efreyes2026-gif/STAB-KIT-PRO-SelfBalancingRobot/Otros/Fotos_Imagenes/PROT_1.jpeg

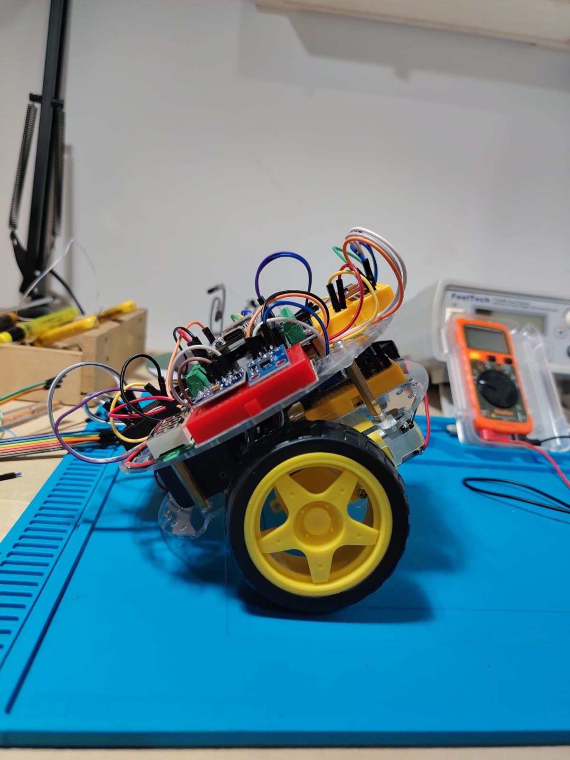
Otros/Fotos_Imagenes/PROT_1.jpeg
