efreyes2026-gif/STAB-KIT-PRO-SelfBalancingRobot/Otros/Fotos_Imagenes/Proteus_WokWI.png

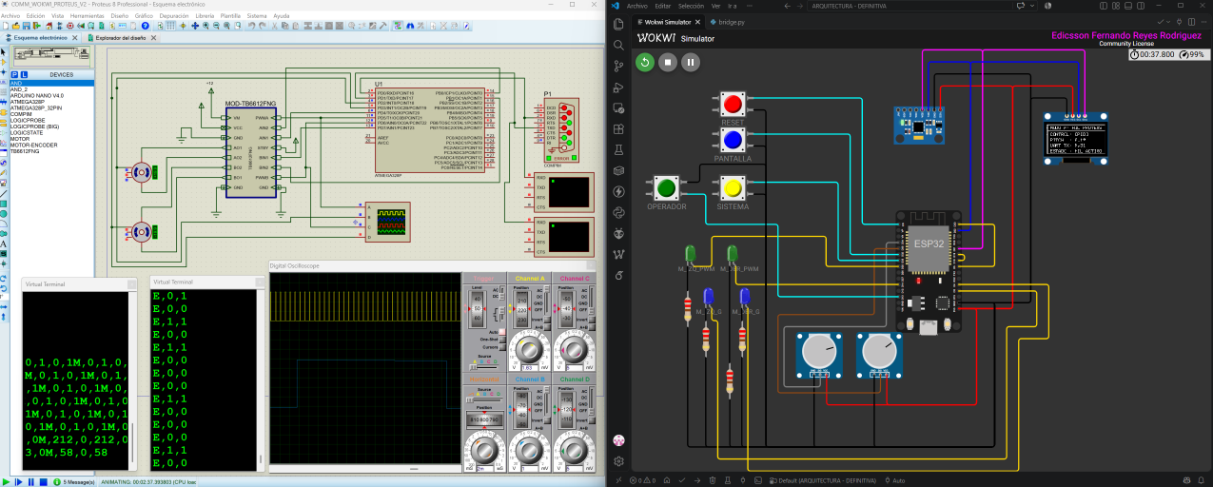
Otros/Fotos_Imagenes/Proteus_WokWI.png
