efreyes2026-gif/STAB-KIT-PRO-SelfBalancingRobot/Mod_3D_Autodesk_Inventor/Robot_Autoequilibrado/Robot_Autoequilibrado_Proyectado.png

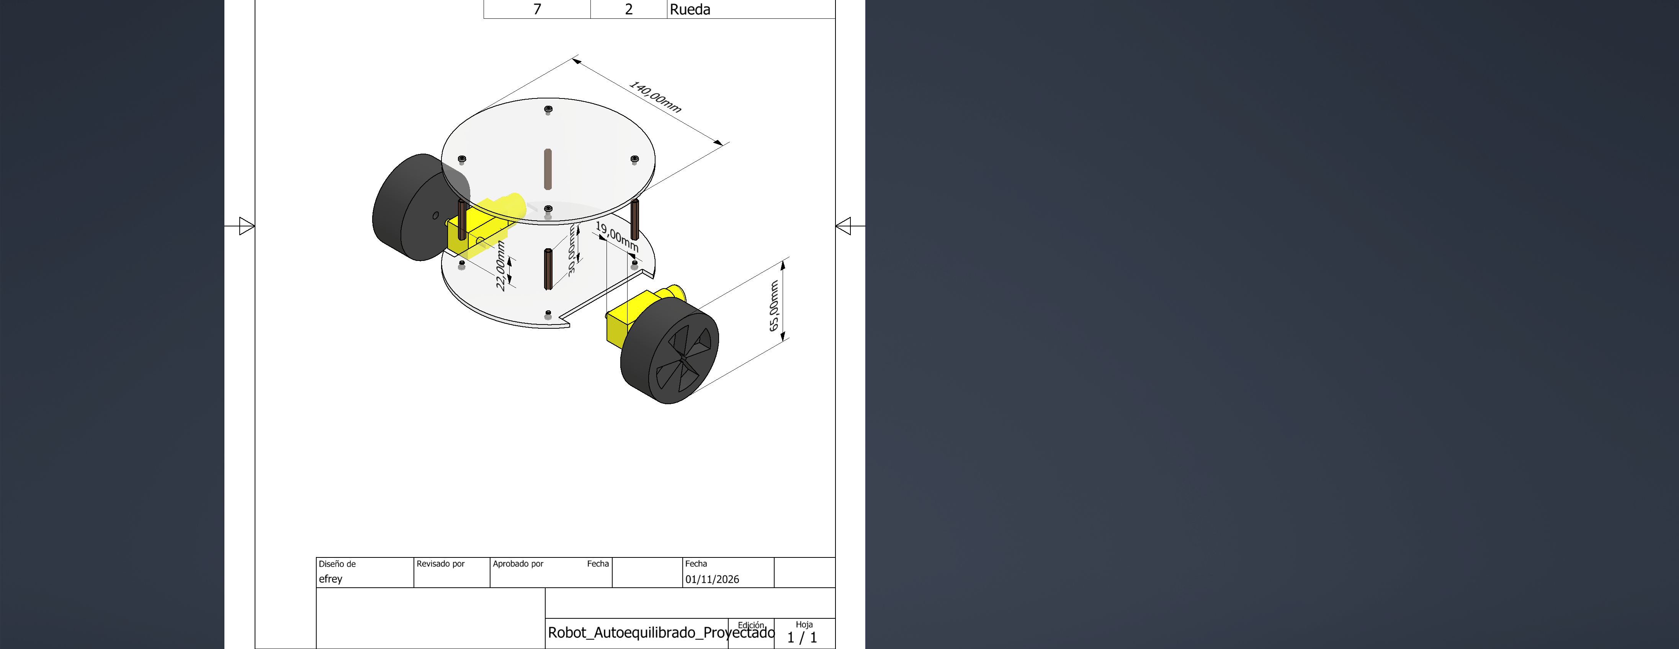
Mod_3D_Autodesk_Inventor/Robot_Autoequilibrado/Robot_Autoequilibrado_Proyectado.png
