efreyes2026-gif/STAB-KIT-PRO-SelfBalancingRobot/Otros/Diag_Flujo_Modelo_Matematico.png

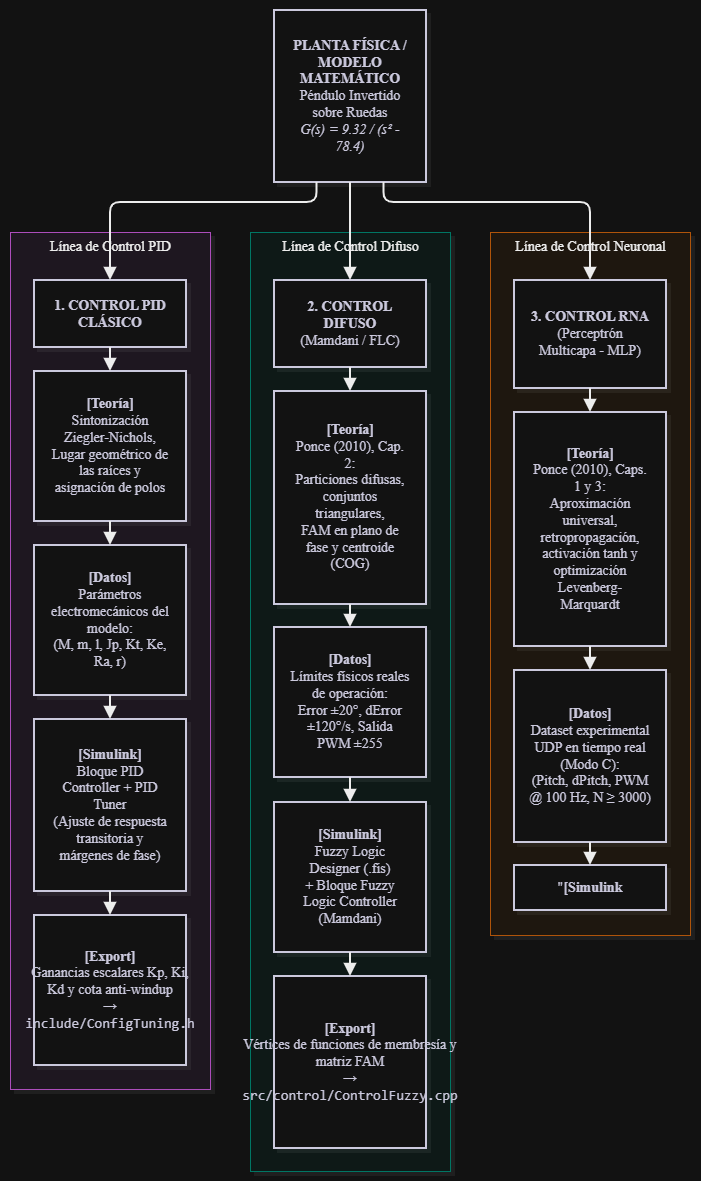
Otros/Diag_Flujo_Modelo_Matematico.png
