efreyes2026-gif/STAB-KIT-PRO-SelfBalancingRobot/Otros/Diagrama_Flujo_firmware.drawio.png

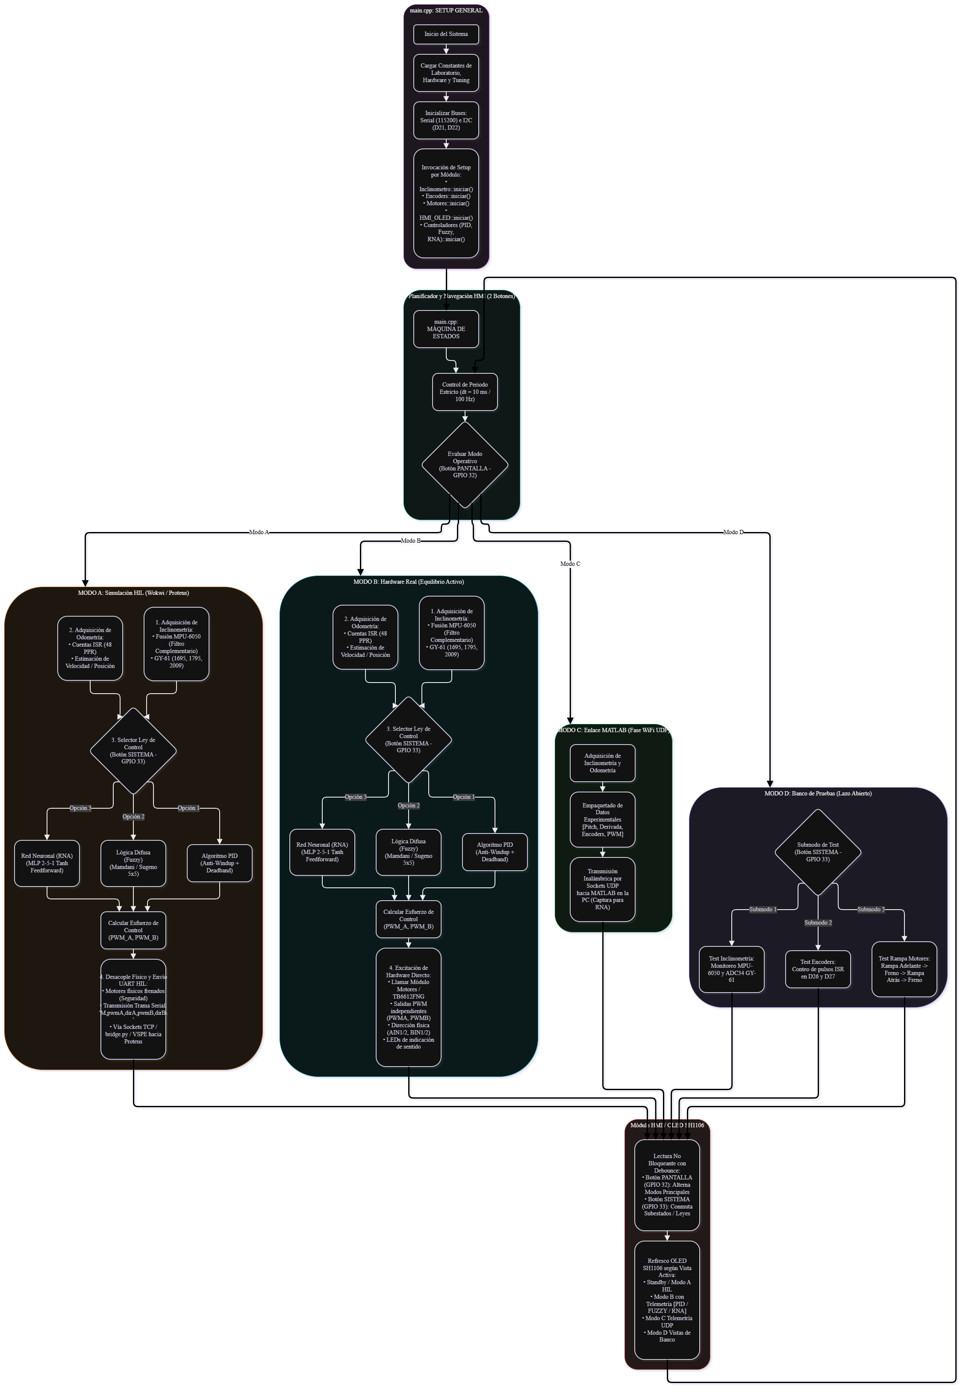
Otros/Diagrama_Flujo_firmware.drawio.png
