efreyes2026-gif/STAB-KIT-PRO-SelfBalancingRobot/Otros/Fotos_Imagenes/CONSOLA_KIT.png

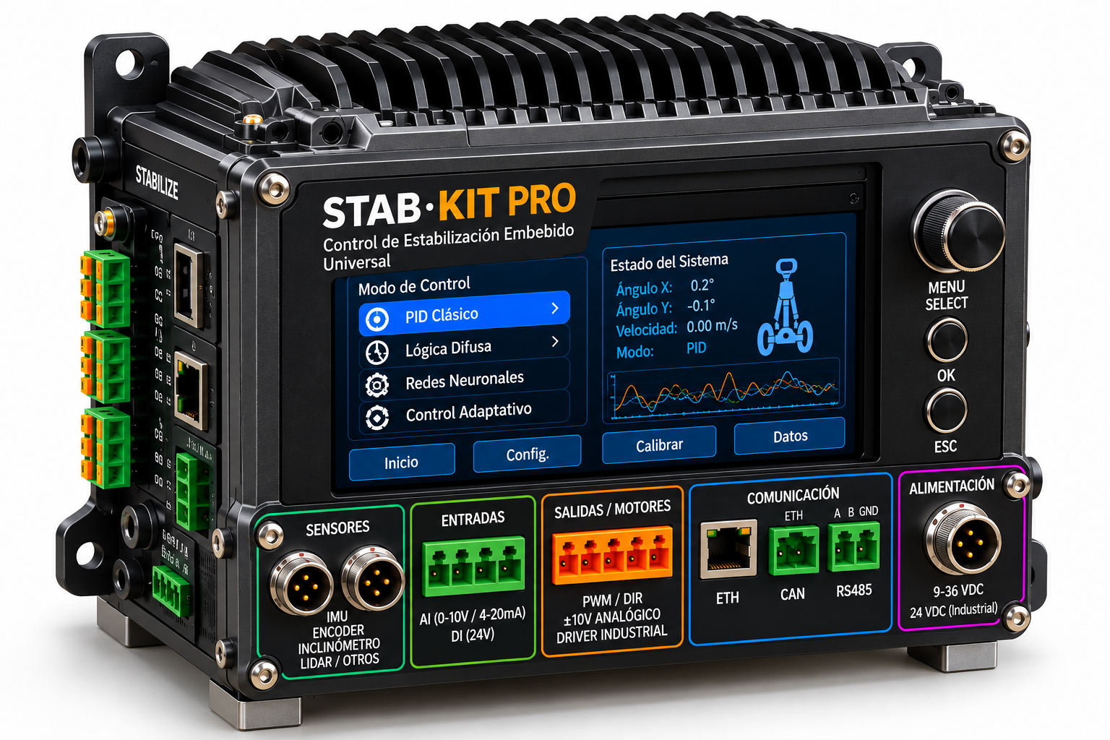
Otros/Fotos_Imagenes/CONSOLA_KIT.png
