efreyes2026-gif/STAB-KIT-PRO-SelfBalancingRobot/Otros/Fotos_Imagenes/Desempe.png

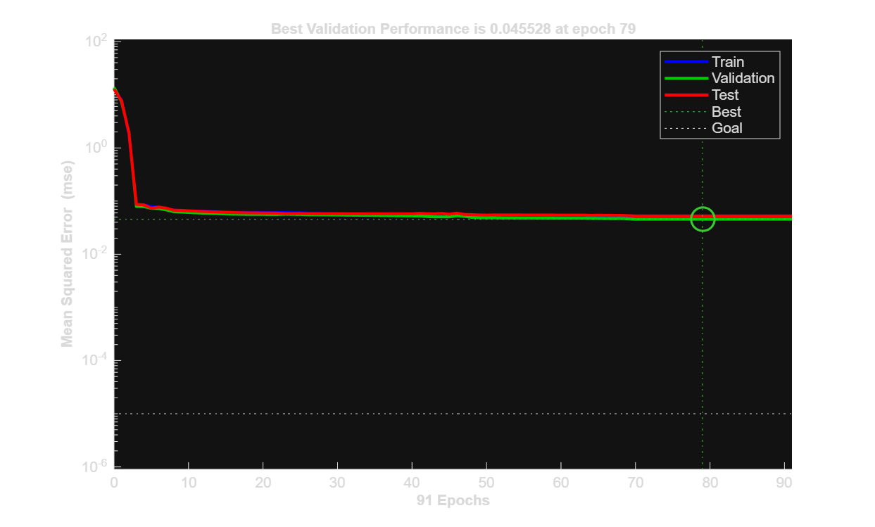
Otros/Fotos_Imagenes/Desempe.png
