efreyes2026-gif/STAB-KIT-PRO-SelfBalancingRobot/Otros/Fotos_Imagenes/Esquema_Mecanico_Multibody1.png

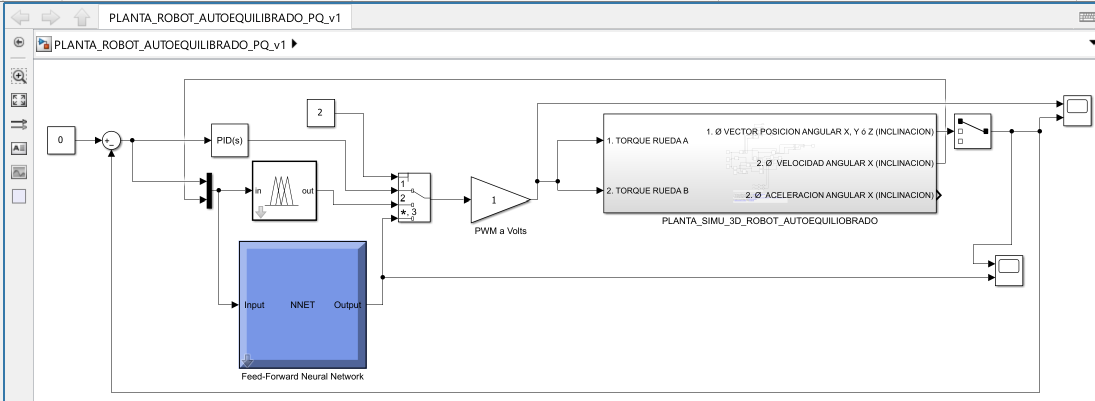
Otros/Fotos_Imagenes/Esquema_Mecanico_Multibody1.png
