efreyes2026-gif/STAB-KIT-PRO-SelfBalancingRobot/Otros/Fotos_Imagenes/Mod_3D_Multibody.png

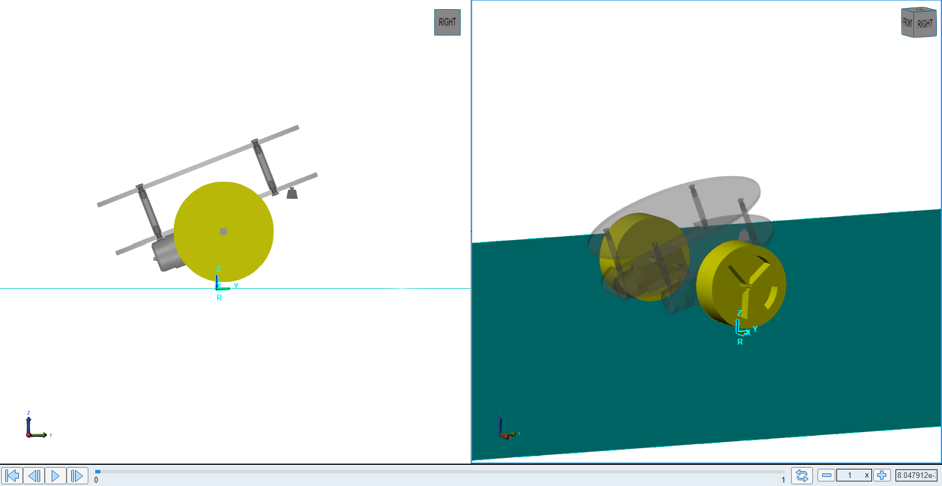
Otros/Fotos_Imagenes/Mod_3D_Multibody.png
