efreyes2026-gif/STAB-KIT-PRO-SelfBalancingRobot/Otros/Fotos_Imagenes/Robot_Autoequilibrado_Proyectado.png

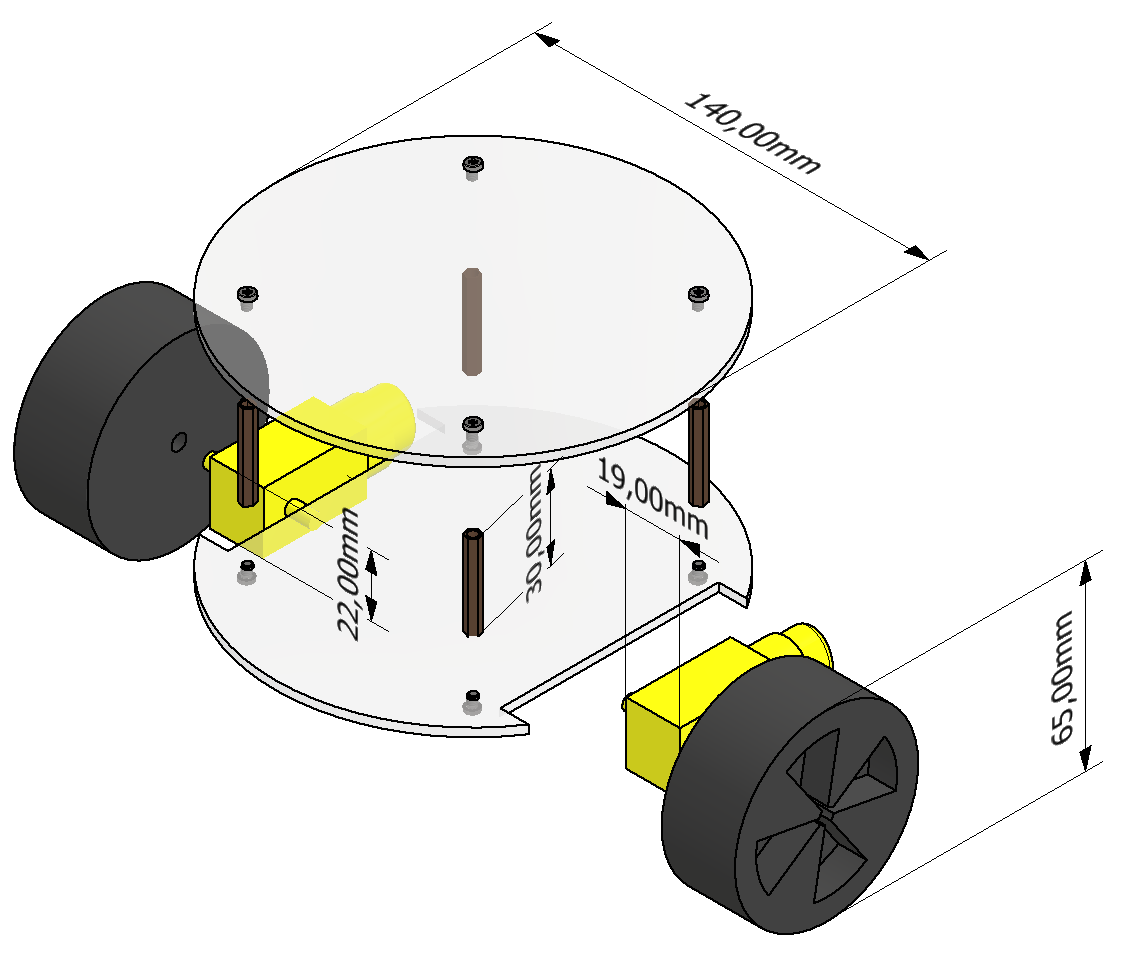
Otros/Fotos_Imagenes/Robot_Autoequilibrado_Proyectado.png
