efreyes2026-gif/STAB-KIT-PRO-SelfBalancingRobot/Otros/Fotos_Imagenes/Superficie_Control_Difuso.png

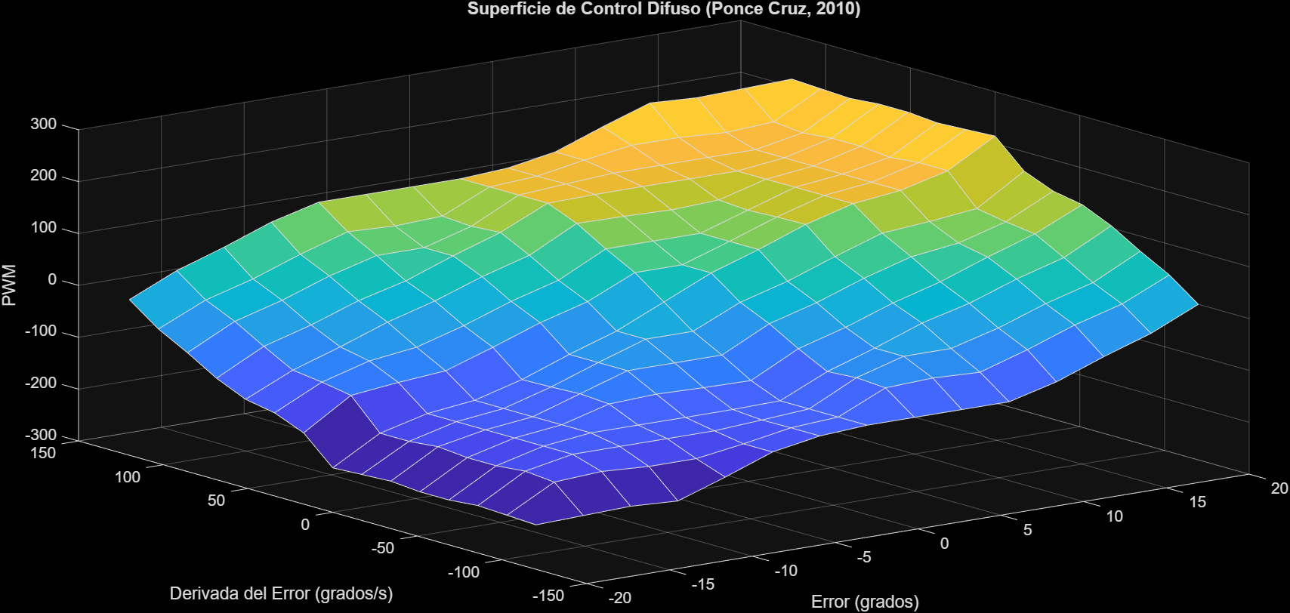
Otros/Fotos_Imagenes/Superficie_Control_Difuso.png
