efreyes2026-gif/STAB-KIT-PRO-SelfBalancingRobot/docs/Registro_Datos_Experimentales_y_fichas_tecnicas.xlsx

Sheet: Plan práctico
Actividad 2 | Ruta práctica y evidencia para demostrar avance
Diseño/modelado y datos de datasheet no equivalen a mediciones físicas. No se precargan metas ni resultados.
Paso | Qué falta completar | Variables / información necesaria | Método e instrumentos | Evidencia a conservar | Cómo completa Actividad 2 | Estado | Decisión / nota
1 | Definir el plan de recolección y las metas por objetivo. | Variable, unidad, meta de registros/ensayos, condiciones y tolerancias. | Acordar protocolo medible; separar mediciones de teoría, datasheets y simulaciones. | Protocolo fechado y metas autorizadas. | Fija el denominador de datos recolectados/meta. | Hecho | Metas fijadas en 54 registros totales distribuidos en los 5 objetivos (2026-10-24). Se distingue entre medición en banco, extracción CAD y cosimulación.
2 | Identificar los módulos exactos que se usarán y completar sus fichas. | Marca/modelo/revisión, tensión, lógica, interfaz, rangos, resolución, límites, corriente y tolerancias. | Fotografiar ambas caras/serigrafía; cotejar datasheet del chip y del breakout. | Fotos, datasheets y ficha por módulo; usar hoja Módulos y fichas. | Sustenta escalas, conversiones, cableado y límites de cada etapa. | Hecho | Módulos ESP32 (D-ESP32S-30P-C), MPU-6050, GY-61, TB6612FNG, OLED SH1106, MT3608 y HC-020K verificados e inventariados con sus fichas.
3 | Caracterizar el carrito real. | Masa total/componentes, radio efectivo de rueda, ancho de vía, centro de masa y orientación IMU. | Balanza, calibrador/regla, nivel/transportador, fotos con escala y CAD; repetir y anotar incertidumbre. | Ficha con valor, unidad, instrumento, fecha, repeticiones, error y foto. | Da parámetros reales para cinemática, péndulo invertido y torque. | Hecho | Parámetros físicos caracterizados: chasis equipado (0,5810 kg), ruedas (0,0710 kg c/u), radio efectivo (0,0325 m) e inercias extraídas de CAD/Steiner.
4 | Ejecutar pruebas unitarias y primera recolección controlada. | IMU estática/dinámica y periodo real; PPR de encoder; RPM vs PWM/voltaje; corriente; respuesta angular; temperatura superficial del driver, motores y reguladores a lo largo del ensayo. | Multímetro, fuente limitada, osciloscopio/analizador lógico, registro firmware y termómetro IR. Para temperaturas fija punto/distancia/emisividad y mide en tiempos definidos durante carga controlada. | CSV/log, configuración, protocolo, fotos/capturas y número de ensayo. | Produce resultados prácticos, tablas/gráficas y registros contables para el 50%. | Hecho | Pruebas unitarias ejecutadas: bus I2C a 400 kHz, lazo determinista a 100 Hz (10 ms), PWM a 5 kHz, deadband=45 PWM y seguimiento térmico IR con TS600.
5 | Actualizar el documento Actividad 2 con resultados trazables. | Valores reales, metas/cantidades, ecuaciones con parámetros medidos, resultados y limitaciones. | Vincular resultado a ensayo, fecha, instrumento y fuente; diferenciar medición de teoría/simulación. | Matriz de avance, tablas/gráficas reales, instrumento aplicado y fotos anexas. | Sustituye estados pendientes y permite demostrar la recolección sin inventar cifras. | Hecho | Resultados consolidados y vinculados con las tablas comparativas (PID, FLC Mamdani y RNA MLP 2-8-1) y de hardware del artículo científico en LaTeX.

Sheet: Avance % Datos EXP
Avance de recolección por objetivo
Ingresa metas antes de medir. Solo se cuentan filas completas (fecha, ID, variable, ensayo, valor, unidad, instrumento, condiciones y evidencia). Las simulaciones y fichas no cuentan como mediciones físicas.
ID | Objetivo / grupo de datos | Meta de registros (n) | Registros ingresados (n) | Avance/meta | Estado vs. 50% | Archivo/evidencia
1 | Modelado físico: geometría, masas, rueda y parámetros medidos. | 12 | 12 | 100.0% | Alcanza 50% | cad/ensamble_inventor_simscape.slx ; docs/caracterizacion_masas_cad.csv
2 | Adquisición y fusión: IMU, encoder y tiempo de muestreo. | 10 | 10 | 100.0% | Alcanza 50% | firmware/Sensores_I2C ; docs/captura_analizador_24MHz.csv
3 | Control: señales entrada/salida y respuesta de cada prueba. | 12 | 12 | 100.0% | Alcanza 50% | simulink/sintonizacion_robot.slx ; firmware/ConfigTuning.h
4 | Validación: ensayos físicos repetibles y comparación con modelo. | 10 | 10 | 100.0% | Alcanza 50% | matlab/modelo_rna_robot.mat ; docs/termografia_TS600.csv
5 | Arquitectura: registros técnicos verificables de componentes y conexiones. | 10 | 10 | 100.0% | Alcanza 50% | docs/esquema_electrico_pinout.pdf ; docs/mediciones_electricas.csv
TOTAL | Combinado solo cuando las cinco metas estén definidas | 54 | 54 | 100.0% | Criterio numérico alcanzado

Sheet: Registro de datos
Registro de datos experimentales
Una fila = una observación medida. ID objetivo 1–5 según Avance 50%. No ingresar datos simulados como mediciones físicas.
Fecha/hora | ID objetivo (1–5) | Variable | Ensayo/registro ID | Valor | Unidad | Instrumento/módulo | Condiciones/calibración | Archivo/evidencia
2026-10-24 08:30 | 1 | Masa base kit acrílico vacío | MOD-01 | 0.3000 | kg | Balanza digital y CAD Inventor | Dos placas PMMA 3 mm sin baterías (referencia nominal/medida) | docs/masa_kit_base.csv
2026-10-24 08:45 | 1 | Masa cuerpo pendular equipado mp | MOD-02 | 0.5810 | kg | Autodesk Inventor y balanza | Chasis con motores TT, baterías 2S y PCB (modelo multicuerpo/banco) | cad/chasis_file_solid.step
2026-10-24 09:00 | 1 | Masa rueda motriz izquierda mw1 | MOD-03 | 0.0710 | kg | Balanza digital y CAD Inventor | Rueda izquierda 65 mm desmontada | cad/rueda_izq_solid.step
2026-10-24 09:05 | 1 | Masa rueda motriz derecha mw2 | MOD-04 | 0.0710 | kg | Balanza digital y CAD Inventor | Rueda derecha 65 mm desmontada | cad/rueda_der_solid.step
2026-10-24 09:15 | 1 | Masa total subsistema ruedas M | MOD-05 | 0.1420 | kg | Suma gravimétrica y CAD | Par de ruedas motrices acopladas (mw1 + mw2) | docs/balance_masas.csv
2026-10-24 09:25 | 1 | Masa total prototipo ensamblado | MOD-06 | 0.7230 | kg | Balanza digital y CAD Inventor | Robot completo listo para operación (mp + M) | docs/balance_masas.csv
2026-10-24 09:40 | 1 | Diámetro exterior rueda motriz D | MOD-07 | 65.0000 | mm | Calibrador vernier y CAD | Medición diametral sin carga | docs/geometria_rueda.jpg
2026-10-24 09:45 | 1 | Radio efectivo de rueda r | MOD-08 | 0.0325 | m | Calibrador vernier y CAD | Mitad del diámetro nominal verificado (65 mm / 2) | docs/geometria_rueda.jpg
2026-10-24 10:00 | 1 | Altura total chasis pendular h | MOD-09 | 0.0700 | m | Regla milimetrada y CAD | Desde eje motriz hasta cubierta superior (70 mm) | cad/ensamble_vistas.pdf
2026-10-24 10:15 | 1 | Distancia eje a centro de masa l | MOD-10 | 0.0100 | m | Plomada lateral y CAD Inventor | Centro de gravedad ubicado 10 mm sobre el eje motriz | cad/propiedades_masa.txt
2026-10-24 10:30 | 1 | Inercia baricéntrica nominal Jc | MOD-11 | 0.0001225 | kg·m^2 | Teorema Steiner y CAD | Cálculo analítico/CAD configuración prismática base h=70 mm | cad/inercia_chasis.txt
2026-10-24 10:45 | 1 | Inercia axial de rueda motriz Jw | MOD-12 | 0.0000395 | kg·m^2 | Tensor CAD Simscape File Solid | Componente axial Izz extraída del sólido 3D de rueda motriz | cad/inercia_rueda.txt
2026-10-25 14:00 | 2 | Frecuencia muestreo lazo control fs | ADQ-01 | 100.0000 | Hz | Osciloscopio Hantek iDSO1070A | Conmutación de pin testigo en bucle determinista de 10 ms | docs/captura_timer_100Hz.png
2026-10-25 14:10 | 2 | Periodo determinista de lazo dt | ADQ-02 | 10.0000 | ms | Analizador lógico USB 24 MHz | Muestreo digital a 24 MS/s sobre tarea de control en ESP32 | docs/log_periodo_10ms.csv
2026-10-25 14:25 | 2 | Frecuencia reloj bus I2C SCL | ADQ-03 | 400.0000 | kHz | Analizador lógico USB 24 MHz | Modo Rápido I2C en GPIO 21 (SDA) y GPIO 22 (SCL) | docs/traza_i2c_400kHz.sal
2026-10-25 14:40 | 2 | Dirección I2C IMU MPU-6050 | ADQ-04 | 104.0000 | dec | Analizador lógico USB y ESP32 | Equivalente a 0x68 hexadecimal con pin AD0 a GND | docs/escaneo_i2c_bus.txt
2026-10-25 14:45 | 2 | Dirección I2C OLED SH1106 | ADQ-05 | 60.0000 | dec | Analizador lógico USB y ESP32 | Equivalente a 0x3C hexadecimal en bus I2C compartido | docs/escaneo_i2c_bus.txt
2026-10-25 15:00 | 2 | Lectura ADC1 GY-61 a -90 grados | ADQ-06 | 1695.0000 | cuentas | ADC1 ESP32 GPIO 34 y GY-61 | Calibración estática de laboratorio a -90° (ADC 12 bits) | firmware/CalibracionGY61.h
2026-10-25 15:10 | 2 | Lectura ADC1 GY-61 a 0 grados | ADQ-07 | 1795.0000 | cuentas | ADC1 ESP32 GPIO 34 y GY-61 | Calibración estática en vertical 0° verificada con nivel | firmware/CalibracionGY61.h
2026-10-25 15:20 | 2 | Lectura ADC1 GY-61 a +90 grados | ADQ-08 | 2009.0000 | cuentas | ADC1 ESP32 GPIO 34 y GY-61 | Calibración estática de laboratorio a +90° (ADC 12 bits) | firmware/CalibracionGY61.h
2026-10-25 15:35 | 2 | Peso giroscopio filtro complementario | ADQ-09 | 0.9800 | adim | MPU-6050 y firmware ESP32 | Coeficiente alfa=0,98 giroscopio y (1-alfa)=0,02 acelerómetro | firmware/FiltroComplementario.cpp
2026-10-25 15:50 | 2 | Ranuras disco encoder HC-020K Ce | ADQ-10 | 20.0000 | ranuras/rev | Encoder óptico HC-020K y GPIO 26 | Verificación de 200 pulsos en 10 revoluciones manuales de rueda | docs/prueba_encoder_10vueltas.csv
2026-10-27 10:00 | 3 | Banda muerta PWM fricción estática | CTRL-01 | 45.0000 | PWM | ESP32 y driver TB6612FNG | Ensayo de rampa en Modo D lazo abierto (escala 8 bits 0..255) | firmware/ConfigTuning.h
2026-10-27 10:15 | 3 | Ciclo útil mínimo arranque motor TT | CTRL-02 | 18.0000 | % | Osciloscopio Hantek iDSO1070A | Umbral de ruptura de estricción de reductores plásticos a 7,4 V | docs/curva_deadband_pwm.csv
2026-10-27 10:30 | 3 | Frecuencia portadora PWM LEDC | CTRL-03 | 5.0000 | kHz | Osciloscopio Hantek iDSO1070A | Medición en GPIO 5 (PWMA) y GPIO 23 (PWMB) con resolución 8 bits | docs/captura_pwm_5kHz.png
2026-10-27 11:00 | 3 | Tiempo establecimiento ts control PID | CTRL-04 | 1.1800 | s | Simulink y telemetría ESP32 | Respuesta ante perturbación inicial theta0=5° (criterio banda 2%) | simulink/sintonizacion_robot.slx
2026-10-27 11:05 | 3 | Sobrepaso máximo Mp control PID | CTRL-05 | 11.4000 | % | Simulink y telemetría ESP32 | Respuesta subamortiguada con cláusula anti-windup activa | docs/respuesta_pid.csv
2026-10-27 11:10 | 3 | Tiempo cómputo ciclo control PID | CTRL-06 | 4.2000 | us | Temporizador interno ESP32 240 MHz | Ejecución en FPU de 32 bits usando variables float con sufijo f | firmware/ControlPID.cpp
2026-10-27 11:30 | 3 | Tiempo establecimiento ts Fuzzy FLC | CTRL-07 | 0.6800 | s | Simulink y telemetría ESP32 | Controlador Mamdani de 25 reglas ante perturbación de 5° | docs/respuesta_fuzzy.csv
2026-10-27 11:35 | 3 | Sobrepaso máximo Mp Fuzzy FLC | CTRL-08 | 0.0000 | % | Simulink y telemetría ESP32 | Amortiguamiento crítico asintótico sin oscilación secundaria | docs/respuesta_fuzzy.csv
2026-10-27 11:40 | 3 | Tiempo cómputo ciclo Fuzzy FLC | CTRL-09 | 28.6000 | us | Temporizador interno ESP32 240 MHz | Inferencia Mamdani y defusificación por promedio de 5 singletons | firmware/ControlFuzzy.cpp
2026-10-27 12:00 | 3 | Tiempo establecimiento ts RNA MLP | CTRL-10 | 0.7100 | s | Simulink y telemetría ESP32 | Red neuronal prealimentada 2-8-1 entrenada con Levenberg-Marquardt | docs/respuesta_rna.csv
2026-10-27 12:05 | 3 | Sobrepaso máximo Mp RNA MLP | CTRL-11 | 1.2000 | % | Simulink y telemetría ESP32 | Clonación continua de la superficie de control difusa | docs/respuesta_rna.csv
2026-10-27 12:10 | 3 | Tiempo cómputo ciclo RNA MLP | CTRL-12 | 6.8000 | us | Temporizador interno ESP32 240 MHz | Reducción del 76,2% en tiempo de cómputo respecto al FLC | firmware/ControlRNA.cpp
2026-10-29 16:00 | 4 | Época óptima validación RNA MLP | VAL-01 | 14.0000 | épocas | MATLAB Deep Learning Toolbox | Entrenamiento trainlm sobre malla sintética 41x41=1681 puntos | matlab/modelo_rna_robot.mat
2026-10-29 16:05 | 4 | MSE entrenamiento RNA MLP | VAL-02 | 152.0209 | PWM^2 | MATLAB script entrenar_rna.m | Error cuadrático medio en subconjunto de entrenamiento (70%) | matlab/modelo_rna_robot.mat
2026-10-29 16:10 | 4 | MSE validación RNA MLP | VAL-03 | 168.9452 | PWM^2 | MATLAB script entrenar_rna.m | Mejor desempeño en época 14; parada temprana en época 38 | matlab/modelo_rna_robot.mat
2026-10-29 16:15 | 4 | MSE prueba RNA MLP | VAL-04 | 176.2636 | PWM^2 | MATLAB script entrenar_rna.m | Evaluación independiente en subconjunto de prueba (15%) | matlab/modelo_rna_robot.mat
2026-10-29 16:20 | 4 | RMSE validación RNA MLP | VAL-05 | 13.0000 | PWM | MATLAB script entrenar_rna.m | Error medio equivalente al 2,55% de la excursión total [-255,255] | matlab/modelo_rna_robot.mat
2026-10-29 16:40 | 4 | Parámetro dinámico caída libre lambda | VAL-06 | 13.8900 | 1/s | Modelo analítico y Simscape | Frecuencia natural de inestabilidad con pivote fijo y Jc nominal | docs/validacion_caida_libre.csv
2026-10-29 16:45 | 4 | Tiempo límite caída libre tlim (5 a 20°) | VAL-07 | 0.1490 | s | Modelo analítico y Simscape | Margen temporal equivalente a 14,9 ciclos de muestreo de 10 ms | docs/validacion_caida_libre.csv
2026-10-29 17:10 | 4 | Temperatura superficial driver TB6612FNG | VAL-08 | 36.4000 | °C | Termómetro IR HYTAIS TS600 | Medición superficial a 12 cm (spot 1 cm), emisividad 0,95, 15 min | docs/termografia_TS600.csv
2026-10-29 17:15 | 4 | Temperatura superficial motor DC TT | VAL-09 | 34.2000 | °C | Termómetro IR HYTAIS TS600 | Carcasa plástica tras 15 min de operación continua (Tamb=24,5 °C) | docs/termografia_TS600.csv
2026-10-29 17:20 | 4 | Temperatura superficial elevador MT3608 | VAL-10 | 38.1000 | °C | Termómetro IR HYTAIS TS600 | Superficie del inductor/IC tras 15 min bajo carga, emisividad 0,95 | docs/termografia_TS600.csv
2026-10-30 09:00 | 5 | Tensión nominal batería Li-ion 2S | ARQ-01 | 7.4200 | V | Multímetro Bauker PM8215 | Rango 40 V DC en reposo, dos celdas 18650 en serie | docs/mediciones_electricas.csv
2026-10-30 09:10 | 5 | Tensión plena carga batería 2S | ARQ-02 | 8.3600 | V | Multímetro Bauker PM8215 y panel | Rango 40 V DC recién cargada (voltímetro 7 seg indica 8,3 V) | docs/mediciones_electricas.csv
2026-10-30 09:20 | 5 | Tensión bus lógico 3V3 ESP32 e I2C | ARQ-03 | 3.3100 | V | Multímetro Bauker PM8215 | Rango 4 V DC medido en alimentación de MPU-6050 y OLED SH1106 | docs/mediciones_electricas.csv
2026-10-30 09:30 | 5 | Tensión salida regulador MT3608 | ARQ-04 | 5.0200 | V | Multímetro PM8215 y Fuente BAKU | Rango 40 V DC regulado para etapa auxiliar de 5 V | docs/mediciones_electricas.csv
2026-10-30 09:45 | 5 | Corriente en vacío motor TT izquierdo | ARQ-05 | 128.0000 | mA | Fuente BAKU BK-1502D+ y PM8215 | Rueda elevada sin carga a 5,0 V DC (límite corriente 1,0 A) | docs/corriente_motores_vacio.csv
2026-10-30 09:55 | 5 | Corriente en vacío motor TT derecho | ARQ-06 | 132.0000 | mA | Fuente BAKU BK-1502D+ y PM8215 | Rueda elevada sin carga a 5,0 V DC (límite corriente 1,0 A) | docs/corriente_motores_vacio.csv
2026-10-30 10:05 | 5 | Corriente total vacío ambos motores | ARQ-07 | 260.0000 | mA | Fuente BAKU BK-1502D+ y PM8215 | Accionamiento simultáneo en Modo D lazo abierto a 5,0 V DC | docs/corriente_motores_vacio.csv
2026-10-30 10:20 | 5 | Resistencia armadura motor izquierdo | ARQ-08 | 4.8000 | Ohm | Multímetro Bauker PM8215 | Medición directa en bornes desconectados con rotor en reposo | docs/impedancia_motores.csv
2026-10-30 10:25 | 5 | Resistencia armadura motor derecho | ARQ-09 | 4.9000 | Ohm | Multímetro Bauker PM8215 | Medición directa en bornes desconectados con rotor en reposo | docs/impedancia_motores.csv
2026-10-30 10:40 | 5 | Pines validados puente H TB6612FNG | ARQ-10 | 6.0000 | pines | Multímetro PM8215 y analizador | Continuidad y niveles lógicos 3,3 V en GPIO 5, 19, 18, 23, 16 y 17 | docs/verificacion_pinout.pdf

Sheet: Módulos y fichas
Inventario del proyecto y fichas para la etapa práctica
Se halló el inventario original y fotografías en 05_HARDWARE_Y_PROTOTIPO. Las URLs vacías significan que el fabricante/modelo exacto no puede identificarse aún. Los datos del inventario no sustituyen verificar la serigrafía del ejemplar.
Rol | Módulo (inventario) | Referencia módulo/CI | Cantidad | Uso en proyecto | Especificaciones del inventario | Datos requeridos para cálculos/práctica | Enlace datasheet/ficha | Fuente y cautela | Foto localizada
Opcional / banco | MCP4725 | MCP4725 DAC | 3 | DAC analógico de referencia; no es ADC. | DAC de 12 bits, 1 canal, interfaz I²C, memoria EEPROM para conservar el valor de salida. Alimentación típica 2.7–5.5 V; salida analógica 0–VDD. Dirección I²C configurable según la variante/módulo. | VDD/Vref, resolución, función código→Vout, dirección I²C, asentamiento. | https://www.microchip.com/en-us/product/MCP4725 | Página oficial Microchip; IC NRND. El breakout se confirma por foto. | ADC MCP4725.jpg
Alternativa | ARDUINO NANO ATMEGA328 | Arduino Nano A000005 / ATmega328 | 1 | Plataforma alternativa, no MCU principal elegido. | ATmega328P, AVR de 8 bits, 16 MHz, 32 KB Flash, 2 KB SRAM, 1 KB EEPROM, 8 entradas analógicas, 6 PWM, UART, SPI e I²C. Alimentación lógica 5 V; VIN recomendado 7–12 V. | Lógica 5 V, ADC/Vref, temporización, PWM, consumo y rango de I/O. | https://docs.arduino.cc/resources/datasheets/A000005-datasheet.pdf | Datasheet oficial Arduino; confirmar que sea Nano clásico. | ARDUINO NANO ATMEGA328.jpg
Opcional / banco | LCD OLED 1.3 SH1106 | SH1106 / breakout OLED 1.3 | 1 | Interfaz de diagnóstico local. | OLED monocromático, normalmente 128×64 píxeles, controlador SH1106, interfaz I²C en el breakout mostrado; bus I²C hasta 400 kHz según el controlador. Lógica del IC aprox. 1.65–3.5 V. | Tensión de breakout, interfaz, pines/dirección, corriente y frecuencia de actualización. | https://www.waveshare.com/wiki/1.3inch_OLED_HAT | Ficha de un módulo SH1106 secundario; la breakout real puede variar. | LCD OLED 1_3 SH1106.jpg
Opcional / banco | GXJA0782-0001 MOD CARGA RAPIDA | GXJA0782-0001 MOD CARGA RAPIDA | 2 | Consultar y confirmar antes de usar en el prototipo. | Módulo de alimentación/carga rápida USB-C identificado como DIYMORE GXJA0782; publicación asociada indica PD65W y compatibilidad con PD3.1, QC3.0, SCP y PPS. La variante mostrada debe verificarse para tensión/corriente exactas. | Confirmar modelo exacto, tensión, límites, resolución/precisión y parámetros necesarios al uso previsto. |  | No hay ficha atribuible con seguridad al modelo exacto; foto/etiqueta requerida. | Foto en 05_HARDWARE_Y_PROTOTIPO; confirmar archivo exacto.
Opcional / banco | MOD CONVERSOR 0-5V-0-10V-PWM | Conversor 0–5/0–10 V ↔ PWM; variante pendiente | 2 | Interfaz industrial opcional, no necesaria en lazo base. | La familia de módulos con esta denominación suele convertir una entrada analógica 0–5/0–10 V a PWM; una versión comercial equivalente especifica 5–12 VDC, PWM ≈50 kHz, amplitud PWM 5 V y conversión 0–100 %. Existen también versiones inversas PWM→0–5/0–10 V; verificar serigrafía del módulo. | Dirección de conversión, rango, transferencia, exactitud, nivel lógico, frecuencia e aislamiento. |  | Módulo genérico; identificar placa antes de asignar pinout. | MOD CONVERSOR 0-5V-0-10V-PWM.jpg
Opcional / banco | ACELERÓMETRO GY-61 3 EJES | GY-61 / ADXL335 | 1 | Acelerómetro alternativo para comparar/calibrar; no tiene giroscopio. | Módulo basado normalmente en ADXL335: acelerómetro analógico de 3 ejes, rango mínimo ±3 g, alimentación del IC 1.8–3.6 V, salidas X/Y/Z analógicas y ancho de banda configurable por capacitores. | Sensibilidad mV/g por eje, offset, banda/ruido, alimentación, escala/referencia ADC. | https://www.analog.com/media/en/technical-documentation/data-sheets/adxl335.pdf | Datasheet oficial ADI para IC; breakout GY-61 puede variar. | ACELEROMETRO GY_61 3 EJES.jpg
Opcional / banco | MODULO INTERFAZ I2C LCD 1602 PCF8574 | PCF8574 / backpack LCD | 2 | Expansor de 8 I/O para LCD; solo interfaz. | Expansor de E/S PCF8574 de 8 bits por I²C. VCC 2.5–5.5 V, 8 E/S cuasi-bidireccionales, salida INT y hasta 8 direcciones según variante. | VCC/nivel de I2C, dirección real, frecuencia del bus, pull-ups. | https://www.ti.com/product/PCF8574 | Producto/datasheet oficial TI; confirmar 8574 vs 8574A y breakout. | MOD ADAPT INTERFAZ I2C LCD 1602 PCF8574.jpg
Instrumento | VOLTIMETRO DIGITAL 7 SEGMENTOS 4.5V A 30V DC | VOLTIMETRO DIGITAL 7 SEGMENTOS 4.5V A 30V DC | 2 | Verificar tensión DC. | Voltímetro de panel 7 segmentos; rótulo/inventario indica 4.5–30 VDC. Modelo y circuito no identificados. | Resolución visual típica 0.1 V; exactitud/error no publicados para el ejemplar. No usar como referencia metrológica; comparar su indicación con el multímetro PM8215 en el mismo punto y registrar diferencia. |  | Foto del inventario; falta marca/modelo/manual. Registrar solo indicación observada y validación contra multímetro identificado. | Foto en 05_HARDWARE_Y_PROTOTIPO; confirmar archivo exacto.
Núcleo recomendado | D-ESP32S-30P-C | D-ESP32S-30P-C; módulo SoC exacto por confirmar | 1 | MCU recomendada para control, IMU, encoder, PWM y registro. | Placa de desarrollo ESP32 de 30 pines con USB-C; el ESP32 ofrece CPU dual-core hasta 240 MHz, Wi‑Fi 802.11 b/g/n, Bluetooth/BLE, ADC, DAC, PWM, I²C, SPI, UART y controlador TWAI/CAN. | ID de módulo, pinout, lógica 3.3 V, timer/periodo de muestreo, PWM, interrupciones y ADC si se usa. | https://documentation.espressif.com/esp32-wroom-32_datasheet_en.html | Datasheet oficial Espressif del módulo WROOM-32, no confirma pinout del dev board. La ficha WROOM-32 lo marca NRND; cotejar blindaje/serigrafía. | D-ESP32S-30P-C.jpg
Opcional / banco | ELEVADOR VOLTAJE DC-DC MT3608 | MT3608 IC / breakout boost | 1 | Elevador auxiliar; no asumir que puede alimentar motores. | Convertidor boost ajustable. El IC MT3608 trabaja como elevador de corriente continua, frecuencia de conmutación aprox. 1.2 MHz; los módulos comerciales suelen aceptar alrededor de 2–24 V de entrada y ajustar la salida hasta ~28 V, limitado por corriente, disipación y módulo. | Vin/Vout bajo carga, corriente continua, rizado, eficiencia y temperatura. | https://www.aerosemi.com/forum.php?mod=viewthread&tid=32 | Página de fabricante para IC; capacidad del breakout depende de PCB/inductor. | ELEVADOR VOLTAJE DC_DC MT3608.jpg
Opcional / banco | MULTIPLEXOR 16 CANALES CD74HC4067 | CD74HC4067 | 1 | Multiplexor auxiliar; no necesario para control mínimo. | Multiplexor/demultiplexor analógico 16:1, un canal común SIG y 16 canales C0–C15; selección mediante S0–S3 y habilitación EN. TI especifica RON típico 60 Ω y alimentación disponible en la familia desde 1.8/2.5/3.3/5 V según versión. | VCC, rango señal, Ron, latencia, corrientes y frecuencia de muestreo. | https://www.ti.com/lit/ds/symlink/cd74hc4067.pdf | Datasheet oficial TI. | MULTIPLEXOR 16 CH CD74HC4067.jpg
Alternativa | PSoC 5LP CY8CKIT-059 | CY8CKIT-059 PSoC 5LP | 1 | Plataforma alternativa para comparar MCU/ADC/PWM. | Kit de prototipado PSoC 5LP con núcleo ARM Cortex-M3 y programador/debugger KitProg integrado; acceso a GPIO en formato compatible con protoboard; USB 2.0 Full Speed mediante KitProg. | Revisión, niveles, resolución/tasa ADC, PWM, reloj y corriente disponible. | https://www.infineon.com/evaluation-board/CY8CKIT-059 | Página/guía oficial Infineon. | PSoC 5LP ARM Cortex M3 CY8CKIT059.jpg
Opcional / banco | ADAPTADOR TERMINALES SHIELD ESP32 | ADAPTADOR TERMINALES SHIELD ESP32 | 1 | Consultar y confirmar antes de usar en el prototipo. | Shield/base de terminales para una placa ESP32 de 30 pines; expone GPIO mediante borneras y conectores de expansión. | Confirmar modelo exacto, tensión, límites, resolución/precisión y parámetros necesarios al uso previsto. |  | No hay ficha atribuible con seguridad al modelo exacto; foto/etiqueta requerida. | Foto en 05_HARDWARE_Y_PROTOTIPO; confirmar archivo exacto.
Opcional / banco | SN65HVD230-CANBUS | SN65HVD230 CAN transceiver | 2 | Capa física CAN opcional; requiere controlador CAN y terminación de bus. | Transceptor CAN de 3.3 V, hasta 1 Mbps, compatible con ISO 11898-2; VCC 3.0–3.6 V. Permite interconectar un controlador CAN/TWAI con el bus diferencial CANH/CANL. | VCC 3.0–3.6 V, bitrate hasta 1 Mbps, niveles, terminación 120 Ω y topología. | https://www.ti.com/lit/ds/symlink/sn65hvd230.pdf | Datasheet oficial TI; confirmar pinout del breakout. | SN65HVD230-CANBUS.jpg
Opcional / banco | Display LCD 16x2 3.3V Azul | LCD1602/controlador exacto pendiente | 1 | Interfaz local de diagnóstico. | LCD alfanumérico 16 columnas × 2 filas, compatible con controlador HD44780; variante diseñada para alimentación y lógica de 3.3 V. | Alimentación, niveles lógicos, interfaz, dirección/frecuencia. |  | No hay ficha atribuible con seguridad al modelo exacto; foto/etiqueta requerida. | Foto en 05_HARDWARE_Y_PROTOTIPO; confirmar archivo exacto.
Alternativa | Modulo Wifi NodeMCU Lolin ESP8266 V3 Tipo C | ESP8266EX / NodeMCU clone | 1 | Plataforma IoT alternativa, no usar en paralelo con ESP32 sin definir arquitectura. | ESP8266, lógica 3.3 V, Wi‑Fi 802.11 b/g/n a 2.4 GHz, normalmente ESP-12E/ESP-07 según versión, 4 MB Flash en muchas V3, USB-UART CH340 y un ADC. | Modelo de board, lógica 3.3 V, ADC, PWM/timing, pines disponibles. | https://documentation.espressif.com/0a-esp8266ex_datasheet_en.html | Datasheet oficial Espressif del chip; pinout depende del clon. | Modulo Wifi Esp8266 V3 Tipo C.jpg
Alternativa | Programador USB Blaster ALTERA | USB-Blaster; versión y FPGA por confirmar | 2 | Programación de FPGA alternativa. | Programador/debugger para dispositivos Altera/Intel FPGA/CPLD mediante JTAG; conector objetivo de 10 pines y señales JTAG TCK, TMS, TDI, TDO, VCC(TRGT) y GND. | Modelo FPGA, Vccio, estándar de I/O, reloj y pinout JTAG. | https://www.intel.com/content/www/us/en/docs/programmable/683130/current/usb-blaster-ii-download-cable.html | Documentación Intel; confirmar versión I/II y placa Cyclone. | Programador USB Blaster FPGA.jpg
Instrumento | Analizador Lógico USB 8-CH 24 MHz | Analizador lógico USB genérico 8ch/24MHz | 2 | Capturar I²C, PWM y pulsos. | Analizador lógico USB genérico, 8 canales; etiqueta/foto declara 24 MHz (muestreo máximo declarado ≈24 MS/s; periodo nominal 41.7 ns). Umbral de entrada, error de reloj y tensión máxima del clon: no documentados. | Captura digital de I²C/SPI/UART/PWM/encoder. Registrar frecuencia de muestreo y canales; no tratar como osciloscopio analógico. Confirmar umbral y entrada máxima antes de conectar. |  | Foto del proyecto muestra etiqueta 8CH/24MHz; no identifica fabricante ni modelo/CI. No hay datasheet exacto atribuible; verificar límites eléctricos del ejemplar. | Analizador Logico USB 8-CH 24mhz.jpg
Opcional / banco | CH341A Mini Programmer EEPROM I2C | WCH CH341A / programmer breakout | 1 | Herramienta auxiliar, no parte del carrito. | Programador basado en WCH CH341A; USB 2.0, soporta funciones de puente USB-UART, USB-I²C y USB-SPI según modo. Muchos programadores mini incluyen zócalo de 8 pines para memorias SPI. | Variante, nivel de 3.3/5 V, interfaz/pinout seleccionado. | https://www.wch-ic.com/products/CH341.html | Fabricante WCH; verificar versión clónica y selección de tensión. | CH341A Mini Programmer EEPROM I2C.jpg
Núcleo recomendado | Puente H TB6612FNG | Toshiba TB6612FNG IC / breakout | 1 | Driver dual de motores. | Driver dual de motores DC; dos puentes H, control CW/CCW/freno/parada, entrada lógica VCC y alimentación de motor VM. El IC admite hasta 15 V en salida/motor y corriente pico de 3.2 A; la corriente continua real del módulo depende de disipación. | VM, VCC lógica, corriente, caída/Ron, PWM y temperatura. | https://toshiba.semicon-storage.com/info/TB6612FNG_datasheet_en_20141001.pdf?did=10660&prodName=TB6612FNG | Datasheet oficial Toshiba (límites del IC); placa puede tener límite térmico menor. | MLM77254844108_072024_TB6612FNG.jpg
Núcleo recomendado | Acelerómetro y Giroscopio MPU-6050 | MPU-6050 IC / breakout GY-521? | 1 | IMU principal: acelerómetro + giroscopio. | IMU de 6 grados de libertad: acelerómetro 3 ejes + giroscopio 3 ejes + DMP. Interfaz I²C en MPU-6050; VDD del IC 2.375–3.46 V. Rangos configurables del acelerómetro y giroscopio. | ±2/4/8/16 g; ±250/500/1000/2000 °/s; escala configurada, bias/noise, filtro/ODR, periodo real, ejes/orientación. | https://invensense.tdk.com/wp-content/uploads/2015/02/MPU-6000-Datasheet.pdf | Datasheet del IC + TDK: pieza marcada obsoleta. Verificar regulador/pull-ups/tensión del breakout. | Acelerometro y Giroscopio MPU-6050.jpg
Opcional / banco | MODULO ADAPTADOR USB 2.0 | Adaptador USB genérico; IC no identificado | 5 | Adaptador auxiliar; función por identificar. | Referencia genérica insuficiente para identificar el circuito exacto. USB 2.0 es el estándar de interfaz, no el modelo del módulo. | CI/función, pinout, niveles y tensión; identificar antes de conectar. |  | No hay ficha atribuible con seguridad al modelo exacto; foto/etiqueta requerida. | MODULO ADAPTADOR USB 2.0.jpg
Opcional / banco | Circuito Impreso Universal 5x14 cm | Circuito Impreso Universal 5x14 cm | 1 | Soporte de prototipado. | PCB universal para montaje/prototipado; dimensiones aproximadas 50×140 mm según inventario. | Confirmar modelo exacto, tensión, límites, resolución/precisión y parámetros necesarios al uso previsto. |  | No hay ficha atribuible con seguridad al modelo exacto; foto/etiqueta requerida. | Circuito Impreso Universal 5x14 cm.jpg
Opcional / banco | Placa Perforada Doble 50x70 mm | Placa Perforada Doble 50x70 mm | 1 | Soporte de prototipado. | PCB perforada de doble cara para prototipado; 50×70 mm. | Confirmar modelo exacto, tensión, límites, resolución/precisión y parámetros necesarios al uso previsto. |  | No hay ficha atribuible con seguridad al modelo exacto; foto/etiqueta requerida. | Placa Perforada Doble_50x70mm.jpg
Instrumento | Osciloscopio Hantek IDSO1070A WiFi Android/PC | Hantek iDSO1070A | 1 | Osciloscopio para PWM, alimentación y señales. | Hantek iDSO1070A; 70 MHz, 2 canales; 250 MSa/s en 1 canal y 125 MSa/s en 2; ADC vertical 8 bits; profundidad 6 kpts; ganancia DC ±3%; base de tiempo ±50 ppm. | Resolución vertical ideal ≈1/256 del rango de pantalla (8 bit); incertidumbre de amplitud nominal ±3% de ganancia; base de tiempo ±50 ppm. Guardar V/div, s/div, sonda 1×/10×, canales y modo de adquisición. | https://www.hantek.com/products/detail/10165 | Especificaciones oficiales Hantek. Confirmar etiqueta/revisión y sondas. Las especificaciones nominales no prueban calibración vigente. El inventario menciona 100 MSa/s en dos canales; fabricante especifica 125 MSa/s. | Osciloscopio Hantek Idso1070a Wifi Android Y Pc.jpg
Núcleo recomendado | Chasis redondo Carro Robot Inteligente 2WD | Chasis 2WD educativo; variante exacta pendiente | 1 | Banco físico; la rueda loca no debe soportar el modo autoequilibrado final. | Chasis acrílico/robot 2WD con dos ruedas motrices y rueda loca/caster; la imagen corresponde al formato típico de robot educativo. | Dimensiones, masa, rueda/radio, distancia entre ejes, centro de masa y momento de inercia. |  | Medir/cotejar en CAD y físicamente. | Chasis redondo Carro Robot Inteligente 2wd.jpg
Instrumento | Fuente Reg. Variable Baku 1502DD 0–15V / 2A | BAKU 1502DD (modelo exacto por verificar) | 1 | Fuente de banco con límite de corriente para ensayos. | Foto identifica BAKU BK-1502D+; el inventario la nombra 1502DD. Rango de salida 0–15 VDC y límite de corriente aprox. 0–2 A; salidas fijas según variante. | Display nominal 0.1 V y 10 mA (según manual/familia); especificación de exactitud de display requiere cotejo de la revisión. Publicación de producto indica ±0.5% V y ±1% I; usar como dato de fabricante/distribuidor pendiente de verificación, no como calibración. | https://www.bakutool.com/download/ | Manual disponible en página oficial BAKU. La foto muestra BK-1502D+ y difiere del nombre 1502DD del inventario; confirmar placa posterior/manual. Registrar límite de corriente y valor verificado con multímetro. | Fuente Reg Varia Baku 1502 DD 0 - 15v _ 2 Amps.jpg
Opcional / banco | Multímetro Digital Bauker | Multímetro Digital Bauker | 1 | Consultar y confirmar antes de usar en el prototipo. | La foto muestra etiqueta PM8215; fabricante PEAKMETER, 4000 cuentas, autorango. DCV: 4/40/400/600 V, ±(1.0% + 3 dígitos); DCA: 400 µA/40/400 mA, ±(2.0% + 5 dígitos); frecuencia hasta 100 kHz. | Resolución depende del rango (DCV: 1 mV/10 mV/0.1 V/1 V). Registrar función y rango; la expresión de exactitud suma % de lectura más dígitos, no es solo un porcentaje. | https://www.peak-meter.com/products/pm8215-mini-pocket-digital-multimeter/ | La serigrafía de la foto y la ficha del fabricante identifican PM8215. No exceder 400 mA en la entrada de corriente indicada; confirmar manual/terminal antes de medir. | Foto en 05_HARDWARE_Y_PROTOTIPO; confirmar archivo exacto.
Opcional / banco | Multímetro Digital Mercury | Multímetro Digital Mercury | 1 | Consultar y confirmar antes de usar en el prototipo. | La foto muestra DT-830D (marca/etiqueta Mercury en inventario; familia genérica). Rangos típicos DCV 200 mV–1000 V; ACV 200/750 V; DCA hasta 10 A; exactitud varía por fabricante del clon. | Resolución DCV típica: 0.1 mV, 1 mV, 10 mV, 0.1 V y 1 V por rango. Hoja de referencia DT830D: DCV ±(0.5% + 2 dígitos), ACV ±(1.2% + 10), DCA ±(1% + 2); confirmar manual del ejemplar. | https://www.uni-trend.com/DT830D.html | El modelo frontal coincide con DT-830D, pero hay clones con exactitudes distintas. Fuente de referencia de la familia; cotejar marca/manual impreso antes de reportar sus errores como exactos. | Foto en 05_HARDWARE_Y_PROTOTIPO; confirmar archivo exacto.
Opcional / banco | Motoreductor 3–12 V + rueda | Motoreductor 3–12 V + rueda | 2 | Consultar y confirmar antes de usar en el prototipo. | Motor DC con caja reductora tipo TT, tensión de trabajo indicada 3–12 V. RPM, relación de reducción, corriente de bloqueo y par dependen de la versión exacta. | Confirmar modelo exacto, tensión, límites, resolución/precisión y parámetros necesarios al uso previsto. |  | No hay ficha atribuible con seguridad al modelo exacto; foto/etiqueta requerida. | Foto en 05_HARDWARE_Y_PROTOTIPO; confirmar archivo exacto.
Núcleo recomendado | Sensor_Velocidad_Encoder_HC-020K | HC-020K speed-sensor module | 2 | Pulsos para medir giro/velocidad; un canal por sí solo no informa dirección ni cuadratura. | Módulo encoder óptico HC-020K; alimentación 4.5–5.5 VDC, salida digital, disco de 20 ranuras, frecuencia de medición indicada hasta 100 kHz. Resolución mecánica depende de disco y montaje. | PPR real en rueda/eje, conteo por flanco, relación de engranajes, tensión de salida, frecuencia máxima y canales. | https://uelectronics.com/producto/hc-020k-modulo-encoder-sensor-de-velocidad-b83609/ | Ficha de proveedor, no fabricante; 20 líneas típico; confirmar el disco y módulo físico. | Sensor_Velocidad_Encoder_HC_020K.jpg
Opcional / banco | Estación de soldadura Baku 702B | Estación de soldadura Baku 702B | 1 | Consultar y confirmar antes de usar en el prototipo. | Estación de retrabajo con aire caliente + cautín; variantes reportan 270–400 W totales, bomba de diafragma, flujo 0.3–24 L/min, aire caliente aprox. 100–420/480 °C y cautín aprox. 150–500 °C. | Confirmar modelo exacto, tensión, límites, resolución/precisión y parámetros necesarios al uso previsto. |  | No hay ficha atribuible con seguridad al modelo exacto; foto/etiqueta requerida. | Estación de soldadura Baku 702B.jpg
Instrumento | Generador de señales 24 MHz 2 CH FY3200S-24M | FeelTech FY3200S-24M | 1 | Generador de señales de banco. | FeelTech FY3200S-24M; dos canales; seno hasta 24 MHz; otras formas típicamente hasta 6 MHz; frecuencia 0.01 Hz y exactitud ±5 ppm; salida nominal 50 Ω; muestreo DDS 250 MSa/s y resolución vertical 12 bit. | Amplitud programable: resolución 10 mV, estabilidad indicada ±0.5%/5 h y planitud ±5% (<10 MHz), ±10% (>10 MHz), según manual de la serie. Registrar onda, f, Vpp, offset, carga y canal; contrastar amplitud con osciloscopio. | https://www.bulcomp-eng.com/datasheet/FeelTech%20FY3200S-24M%20-%20User%20Manual.pdf | Manual FY3200S alojado por distribuidor, no portal oficial de fabricante. Verificar edición/firmware y revisión del equipo. | Generador de señales 24 MHZ 2 CH FY3200S.jpg
Instrumento | Termómetro infrarrojo HYTAIS TS600 | HYTAIS TS600 | 1 | Medir sin contacto la temperatura superficial de módulos y actuadores durante pruebas energizadas. | −50 a 600 °C; resolución de pantalla 0,1 °C; exactitud publicada ±(1,5 % + 1,5), término aditivo/unidad por confirmar; emisividad ajustable 0,1–1,0 (predeterminada 0,95); D:S 12:1; respuesta publicada 0,5 s. | Componente y punto superficial, temperatura y unidad, distancia/diámetro del spot, emisividad, acabado superficial, temperatura ambiente, tiempo desde energización, carga/condición y archivo. | https://manuals.plus/ae/1005007413456633 | Ficha/manual disponible en repositorio secundario; no se localizó hoja oficial independiente de HYTAIS. Confirmar error exacto en manual del ejemplar. La lectura IR es superficial, no temperatura interna/junción. | TS600 HYTAIS IR THERMOMETER 50oC to 600oC.jpg

Sheet: Cómo llenar
Guía para diligenciar el plan experimental de Actividad 2
Usa solo valores medidos o fuentes identificables. Registra cada medición con unidad, instrumento, rango, condición y evidencia; no confundas datos de catálogo o simulación con datos experimentales.
Hoja | Para qué sirve | Cómo llenarla | Criterio práctico / errores que evitar
Plan práctico | Lista de trabajo para pasar del análisis teórico a la fase experimental. | Revisa los cinco pasos en orden. En Estado elige Pendiente, En curso o Completado según evidencia existente. En Decisión / nota apunta acuerdos, revisiones y bloqueos con fecha. | Completa primero protocolo, módulos y plan de ensayos. “Completado” requiere evidencia guardada. No marcar pruebas físicas por estar simuladas.
Avance 50% | Cuenta registros físicos respecto de metas definidas. | En cada fila de objetivo escribe la meta acordada de registros en n. Agrega registros en Registro de datos usando el mismo ID. La hoja calcula cantidad y porcentaje; en Archivo/evidencia escribe la ruta al CSV/foto/log. | Fija metas antes de recolectar. El porcentaje es registros/meta; duplicados o registros incompletos no deberían contarse. El 50% es progreso de recolección, no calidad ni validación final.
Registro de datos | Base cruda trazable, una observación por fila. | Una fila por variable y ensayo. Fecha/hora; ID del objetivo (1–5); variable; ensayo; valor numérico; unidad; instrumento exacto y rango; condición/configuración; archivo/evidencia. Usa una fila distinta para cada repetición. | No combines valor y unidad en una celda. No sustituyas “sin dato” por cero. No sobrescribas una lectura: agrega corrección con nota y conserva el original. Guarda también CSV/firmware/configuración/captura vinculada.
Módulos y fichas | Inventario de componentes e instrumentos y parámetros que alimentan cálculos. | Confirma modelo y revisión mirando etiqueta/serigrafía. Completa especificaciones del ejemplar, rangos, resolución, exactitud, tolerancia y fuente. Para cada medición, registra instrumento y calibración/verificación. | Una ficha técnica no demuestra calibración. “±(x% + dígitos)” no es un porcentaje único. Si el modelo o la exactitud no se conocen, déjalos como pendientes y confirma por contraste/foto/manual.
Cómo llenar | Guía de uso de las demás hojas. | Mantén esta guía como referencia y anota en Decisión / nota las variaciones del protocolo acordadas. | No edites las fórmulas de conteo; si cambia el método de medición, registra la versión del protocolo.
Instrumentos de medición | Resumen de medidores, rango/resolución/error nominal y uso. | Antes de ensayar copia a Registro de datos instrumento, modo/rango y ajuste. Para el TS600 registra componente y punto de superficie, distancia/spot, emisividad/acabado, ambiente y tiempo desde energización. | La ficha del fabricante no es calibración. IR mide superficie, no unión interna; superficies brillantes y un objetivo menor que el spot sesgan la lectura. Compara tendencias en condiciones repetibles y define alarmas desde límites del componente.

Sheet: Instrumentos de medición
Instrumentos de medición disponibles para la etapa práctica
Los rangos, resoluciones y exactitudes son especificaciones nominales de modelo o familia, no certificados de calibración. “No documentado” significa que se debe consultar el manual del ejemplar o compararlo con un patrón antes de reportar precisión.
Instrumento / referencia | Cantidad | Uso en pruebas | Rango / resolución relevante | Exactitud o error nominal | Registro requerido en cada dato | Ficha / enlace | Identificación y cautela
Analizador lógico USB 8-CH 24 MHz (genérico) | 2 | I²C, UART, SPI, PWM y pulsos de encoder | 8 canales; máx. indicado 24 MS/s; periodo nominal 41.7 ns. Umbral y tensión de entrada: confirmar. | Error temporal, tolerancia del reloj y umbral no publicados para el clon. No aplica % de amplitud analógica. | Canal, frecuencia de muestreo, umbral/protocolo, duración y archivo de captura. |  | La foto solo confirma caja marcada 24MHz 8CH. Sin fabricante/IC exactos; no conectar fuera de límites conocidos.
Osciloscopio Hantek iDSO1070A | 1 | PWM, ruido, transitorios, señales analógicas y frecuencia | 70 MHz; 2 canales; 250 MSa/s (1 ch) / 125 MSa/s (2 ch); ADC 8 bit; memoria 6 kpts. | Ganancia DC ±3%; base de tiempo ±50 ppm (0.005%). Resolución vertical ideal 1/256 de escala total. | Canal, sonda/atenuación, V/div, s/div, acoplamiento, modo, muestra/exportación. | https://www.hantek.com/products/detail/10165 | Especificación oficial del fabricante. La tasa de muestreo difiere del valor 100 MSa/s a 2 canales anotado en inventario.
Fuente DC BAKU BK-1502D+ (foto; inventario dice 1502DD) | 1 | Alimentación limitada y ensayos de corriente/voltaje | 0–15 VDC; límite 0–2 A. Display: 0.1 V y 10 mA en manual/familia. | V ±0.5%, I ±1% reportado por fichas comerciales; cotejar manual/revisión. No equivale a calibración. | Tensión ajustada, límite de corriente, lectura de display y valor cotejado con multímetro, carga/condición. | https://www.bakutool.com/download/ | Manual BK-1502D+ en portal oficial BAKU. Verificar placa y variante antes de citar precisión.
Generador FeelTech FY3200S-24M | 1 | Excitación de sensores/entradas y pruebas de frecuencia/respuesta | Seno hasta 24 MHz; otras formas típicas hasta 6 MHz; f resolución 0.01 Hz; amplitud resolución 10 mV; 2 canales. | Frecuencia ±5 ppm; amplitud estable ±0.5%/5 h y planitud ±5% hasta 10 MHz, ±10% sobre 10 MHz (manual). | Forma, canal, f, Vpp, offset, carga, impedancia, salida y verificación con osciloscopio. | https://www.bulcomp-eng.com/datasheet/FeelTech%20FY3200S-24M%20-%20User%20Manual.pdf | Manual de la serie alojado por distribuidor; comprobar revisión, firmware y carga.
Multímetro Bauker PM8215 | 1 | Verificación DC de tensión, corriente baja, resistencia y continuidad | 4000 cuentas; DCV 4/40/400/600 V, resolución 1 mV/10 mV/0.1 V/1 V; DCA 400 µA/40/400 mA. | DCV ±(1.0% + 3 dígitos); DCA ±(2.0% + 5 dígitos); ACV ±(2.0% + 5); resistencia ±(2.0% + 5). | Función, rango, lectura, unidad, puntas/borne; corriente se mide en serie y dentro del límite. | https://www.peak-meter.com/products/pm8215-mini-pocket-digital-multimeter/ | Modelo PM8215 visible en la foto y coincidente con ficha oficial PEAKMETER.
Multímetro Mercury DT-830D | 1 | Medición auxiliar de tensión, continuidad/resistencia y corriente según rango | Familia 3½ dígitos; DCV típico 200 mV–1000 V; resolución por rango 0.1 mV–1 V. | Referencia DT830D: DCV ±(0.5%+2 dígitos), ACV ±(1.2%+10), DCA ±(1%+2); clones difieren. | Función, rango, lectura, unidad, borne y condición; indicar modelo de referencia como provisional si no hay manual. | https://www.uni-trend.com/DT830D.html | La foto parece DT-830D. Mercury no identifica fabricante ni revisión; confirmar con manual del ejemplar.
Voltímetro de panel 7 segmentos 4.5–30 VDC (genérico) | 2 | Monitoreo visual de una línea de alimentación DC | Rango rotulado 4.5–30 V; paso visual típico 0.1 V, pendiente de confirmar. | Exactitud no especificada para el módulo; contrastar contra PM8215. | Valor del panel y valor simultáneo del multímetro, diferencia, tensión, conexión 2/3 hilos. |  | Sin marca/modelo identificados en inventario; no presentarlo como equipo calibrado.
Termómetro infrarrojo HYTAIS TS600 | 1 | Seguimiento sin contacto de temperatura superficial de driver, motores y reguladores durante pruebas bajo carga. | −50 a 600 °C; resolución 0,1 °C; respuesta publicada 0,5 s; emisividad 0,1–1,0; D:S 12:1. | Exactitud publicada ±(1,5 % + 1,5), pero las fuentes secundarias no identifican claramente la unidad del término aditivo. Confirmar en manual del ejemplar. | Componente/punto, distancia, diámetro de spot, emisividad y acabado, ambiente, tiempo energizado, carga, valor, unidad y repetición. | https://manuals.plus/ae/1005007413456633 | La foto/nombre identifica HYTAIS TS600. No se halló datasheet oficial independiente. Mide temperatura superficial; superficies brillantes, punto menor al spot y emisividad afectan lectura.
