efreyes2026-gif/STAB-KIT-PRO-SelfBalancingRobot/Mod_3D_Autodesk_Inventor/Robot_Autoequilibrado/Robot_Autoequilibrado_Chasis.stp

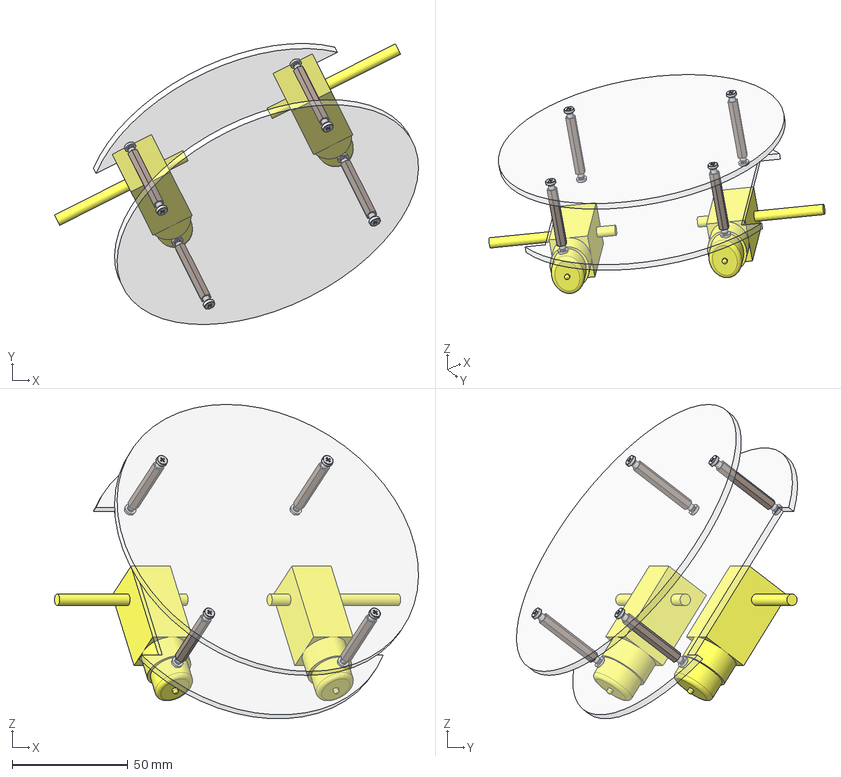
[picture p30: CAD file, 2026-11-03]
Mod_3D_Autodesk_Inventor/Robot_Autoequilibrado/Robot_Autoequilibrado_Chasis.stp
157.1 x 121.3 x 135.6 mm
Chasis_Placa_2
MOTOR_A
MOTOR_B
Screw GB/T 13806.1-1992 A M3 x 4 x 8
SOPORTES_DOBLE_ROSCADOS x 4
Chasis_Placa_1
