efreyes2026-gif/STAB-KIT-PRO-SelfBalancingRobot/(list of files, cad)

Other CAD files:
Mod_3D_Autodesk_Inventor/Robot_Autoequilibrado/Chasis_Placa_1.ipt
Mod_3D_Autodesk_Inventor/Robot_Autoequilibrado/Chasis_Placa_2.ipt
Mod_3D_Autodesk_Inventor/Robot_Autoequilibrado/MOTOR_A.ipt
Mod_3D_Autodesk_Inventor/Robot_Autoequilibrado/MOTOR_B.ipt
Mod_3D_Autodesk_Inventor/Robot_Autoequilibrado/OldVersions/Chasis_Placa.0001.ipt
Mod_3D_Autodesk_Inventor/Robot_Autoequilibrado/OldVersions/Chasis_Placa_1.0001.ipt
Mod_3D_Autodesk_Inventor/Robot_Autoequilibrado/OldVersions/Chasis_Placa_2.0002.ipt
Mod_3D_Autodesk_Inventor/Robot_Autoequilibrado/OldVersions/MOTOR_A.0005.ipt
Mod_3D_Autodesk_Inventor/Robot_Autoequilibrado/OldVersions/MOTOR_B.0002.ipt
Mod_3D_Autodesk_Inventor/Robot_Autoequilibrado/OldVersions/Robot_Autoequilibrado.0001.ipn
Mod_3D_Autodesk_Inventor/Robot_Autoequilibrado/OldVersions/Robot_Autoequilibrado.0002.ipn
Mod_3D_Autodesk_Inventor/Robot_Autoequilibrado/OldVersions/Robot_Autoequilibrado.0007.iam
Mod_3D_Autodesk_Inventor/Robot_Autoequilibrado/OldVersions/Robot_Autoequilibrado_Chasis.0001.iam
Mod_3D_Autodesk_Inventor/Robot_Autoequilibrado/OldVersions/Robot_Autoequilibrado_Proyectado.0001.idw
Mod_3D_Autodesk_Inventor/Robot_Autoequilibrado/OldVersions/Robot_Autoequilibrado_Proyectado.0001.ipn
Mod_3D_Autodesk_Inventor/Robot_Autoequilibrado/OldVersions/Rueda.0001.ipt
Mod_3D_Autodesk_Inventor/Robot_Autoequilibrado/Robot_Autoequilibrado.iam
Mod_3D_Autodesk_Inventor/Robot_Autoequilibrado/Robot_Autoequilibrado.idw
Mod_3D_Autodesk_Inventor/Robot_Autoequilibrado/Robot_Autoequilibrado.ipn
Mod_3D_Autodesk_Inventor/Robot_Autoequilibrado/Robot_Autoequilibrado_Chasis.iam
Mod_3D_Autodesk_Inventor/Robot_Autoequilibrado/Robot_Autoequilibrado_Proyectado.idw
Mod_3D_Autodesk_Inventor/Robot_Autoequilibrado/Robot_Autoequilibrado_Proyectado.ipn
Mod_3D_Autodesk_Inventor/Robot_Autoequilibrado/Rueda.ipt
Mod_3D_Autodesk_Inventor/Robot_Autoequilibrado/SOPORTES_DOBLE_ROSCADOS.ipt
Mod_3D_Autodesk_Inventor/Robot_Autoequilibrado/SUPERFICIE.ipt
