efreyes2026-gif/STAB-KIT-PRO-SelfBalancingRobot/(list of files, drawings)

Other design files:
Proteus/COMM_WOKWI_PROTEUS_V2.pdsprj
Proteus/Project Backups/COMM_WOKWI_PROTEUS_V2 [20261011, 02-30-33].pdsprj
Proteus/Project Backups/COMM_WOKWI_PROTEUS_V2 [20261011, 03-01-57].pdsprj
Proteus/Project Backups/COMM_WOKWI_PROTEUS_V2 [20261011, 03-37-24].pdsprj
Proteus/Project Backups/COMM_WOKWI_PROTEUS_V2 [20261011, 03-48-03].pdsprj
Proteus/Project Backups/COMM_WOKWI_PROTEUS_V2 [20261011, 03-59-24].pdsprj
Proteus/Project Backups/COMM_WOKWI_PROTEUS_V2 [20261011, 03-59-25].pdsprj
Proteus/Project Backups/COMM_WOKWI_PROTEUS_V2 [20261011, 04-07-05].pdsprj
Proteus/Project Backups/COMM_WOKWI_PROTEUS_V2 [20261011, 12-17-09].pdsprj
Proteus/Project Backups/COMM_WOKWI_PROTEUS_V2 [20261016, 21-59-43].pdsprj
Proteus/Project Backups/COMM_WOKWI_PROTEUS_V2 [20261016, 22-29-12].pdsprj
